bleehu/project-defuse/README.md

# project-defuse
A project to make an open-sourced hardware game in a similar vein to
