bleehu/project-defuse/hardware/checklist.md

* Don't design for production
    * Don't try to make a certain size or shape
* Test points
    * Voltages
    * Ground
    * Serial
* Diagnostic LEDs
    * Power
    * Ready LED
* Don't overcrowd
    * 0805
* Silkscreen
    * Label stuff
    * Pin 1 markings
    * Clearly label headers and test points
    * Orientation markings
    * Board name and rev
    * Label ICs
* Isolation jumpers
    * Cuttable jumpers between power sections
* Break out unused GPIO
* Check UART directions
* Double-check footprints
* Check parts availability
