bleehu/project-defuse/hardware/seg25_puzzle/Pinout.md

## Rev 1.0

| Pin # | GPIO # | Function |
| ----- | --- | --- |
| 1 | GP0 | Spare 5V-level-shifted output at TP18
| 2 | GP1 | TPIC6C595 OE - Output enable (active low)
| 4 | GP2 | TPIC6C595 SRCK - Shift register clock
| 5 | GP3 | TPIC6C595 SER_IN - Serial data MOSI
| 6 | GP4 | TPIC6C595 CLR - Clear (active low)
| 7 | GP5 | TPIC6C595 RCK - Register clock
| 9 | GP6 | Unused (why?)
| 10 | GP7 | 74HCT595 RCLK - Register clock
| 11 | GP8 | 74HCT595 SRCLR - Shift register clear (active low)
| 12 | GP9 | 74HCT595 OE - Output enable (active low)
| 14 | GP10 | 74HCT595 SRCLK - Shift register clock
| 15 | GP11 | 74HCT595 SER - Serial data MOSI
| 16 | GP12 | 74HCS165 Q_H - Serial output
| 17 | GP13 | 74HCS165 SH/LD - Shift when high, load when low
| 19 | GP14 | 74HCS165 CLK - Serial clock (rising edge)
| 20 | GP15 | 74HCS165 CLK INH - Clock inhibig (active low)
| 21 | GP16 | Spare - TP1
| 22 | GP17 | Spare - TP2
| 24 | GP18 | Spare - TP3
| 25 | GP19 | Spare - TP4
| 26 | GP20 | Spare - TP5
| 27 | GP21 | Spare - TP6
| 29 | GP22 | Spare - TP7
| 31 | GP26 | Spare - TP9
| 32 | GP27 | Spare - TP10
| 34 | GP28 | Spare - TP11

## Pinout Diagram

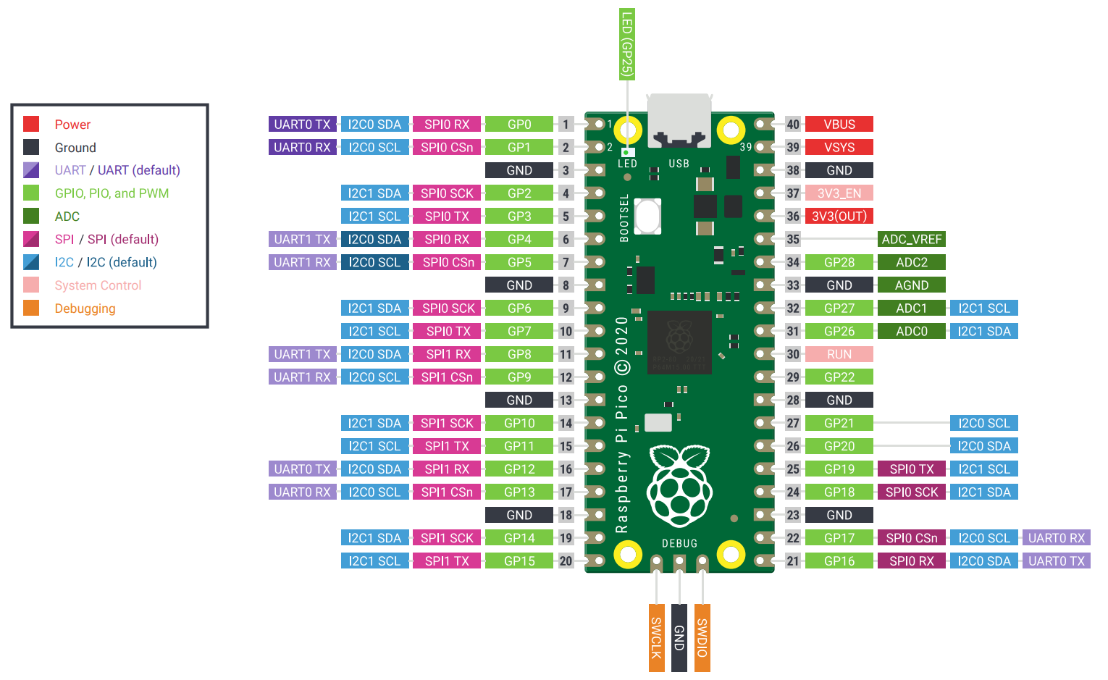
[picture p1: hardware/Pico_pinout.png]
Raspberry Pi Pico pinout diagram
