bleehu/project-defuse/hardware/seg25_puzzle/bom.md

| Qty | Part name | Link |
| --- | --- | ---- |
| 3 | TPIC6C595 | https://www.mouser.com/ProductDetail/595-TPIC6C595DG4
| 1 | 74HCT595  | https://www.mouser.com/ProductDetail/621-74HCT595S16-13
| 2 | 8x DIP switch | https://www.mouser.com/ProductDetail/774-2068
| 2 | 8x resistor array 100k | https://www.mouser.com/ProductDetail/652-4609X-1LF-100K
| 1 | 74HCT367 | https://www.mouser.com/ProductDetail/771-74HCT367D-T
| 1 | Screw terminal 2-pin | https://www.mouser.com/ProductDetail/490-TB003-500-P02BE
| 1 | Raspberry Pi Pico | https://www.mouser.com/ProductDetail/713-102110545
| 7 | BC808 | https://www.mouser.com/ProductDetail/637-BC808-40
| 2 | 74HCS165 | https://www.mouser.com/ProductDetail/595-SN74HCS165DR
| 7 | 100nF 0805 | From stock
| 3 | LED 3mm | From stock
| 2 | Header 3-pin | From stock
| 1 | DYSR00P401101 | https://www.radio741.com/40495-6-digit-16-25-segment-display-common-anode-arduino-compatible-dysr00p401101-micronova.html
|  26 | 1k 0805 | From stock
| 7 | 10k 0805 | From stock
