bleehu/project-defuse/hardware/seg25_puzzle/seg25_puzzle.kicad_pcb

## KiCad design hardware/seg25_puzzle/seg25_puzzle.kicad_pcb (2024-02-07)

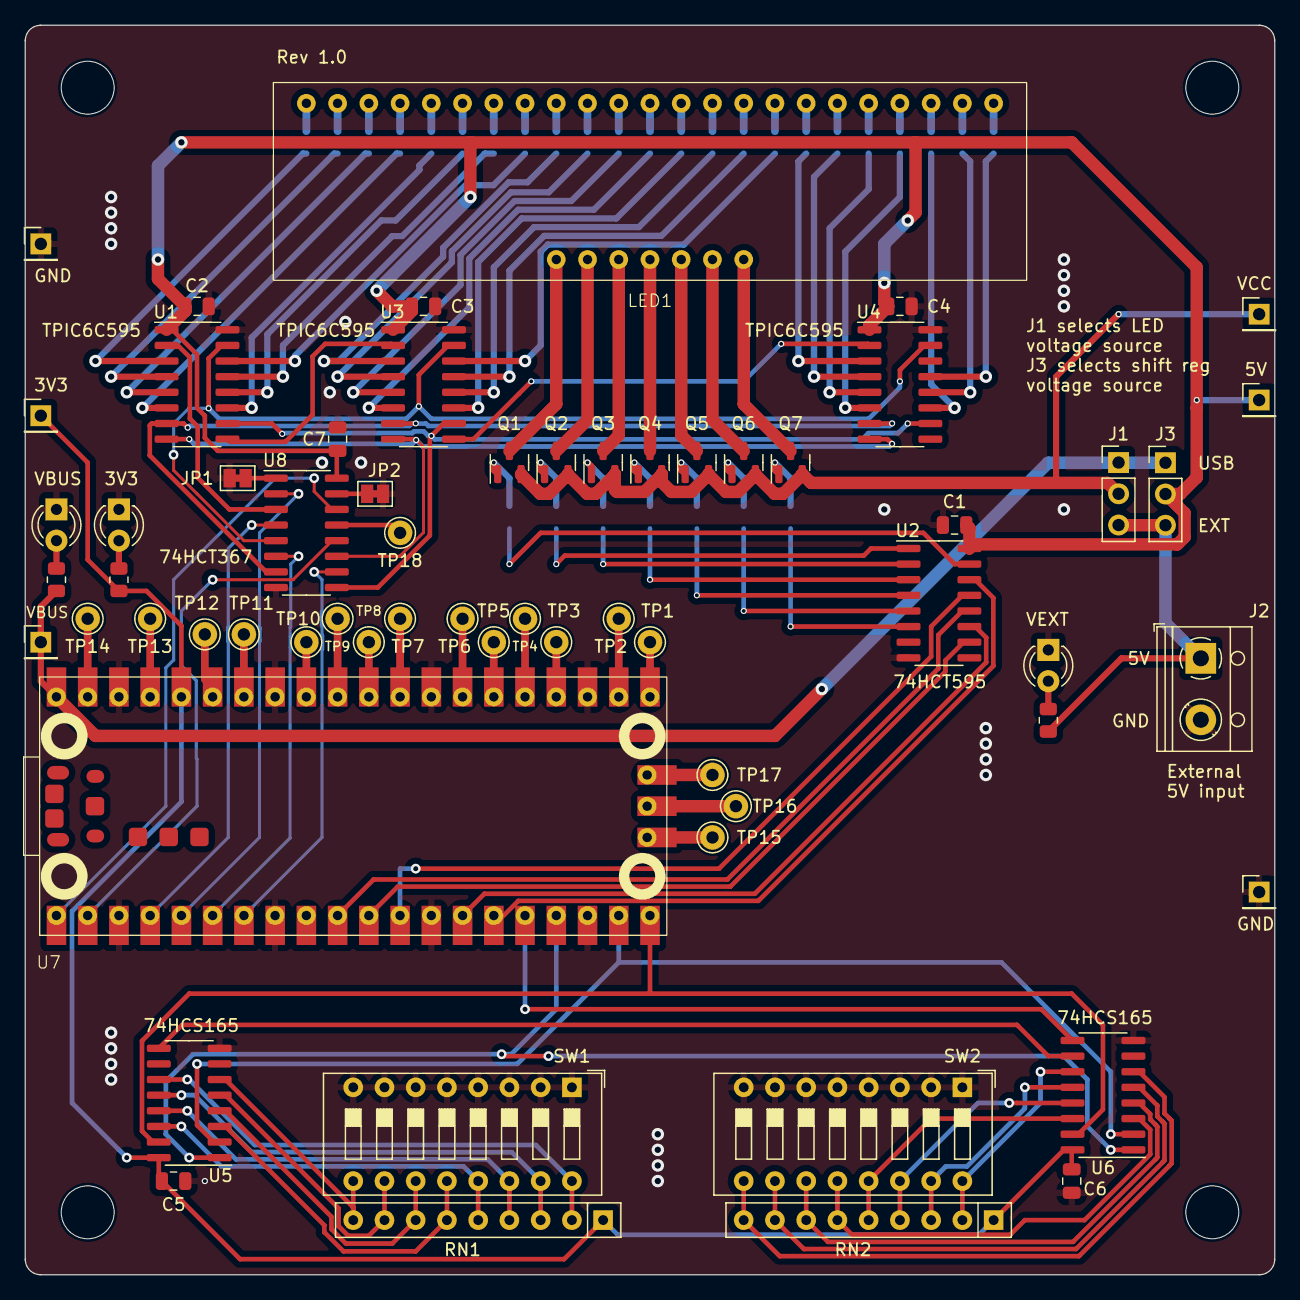
[picture p2: board seg25_puzzle.kicad_pcb from above]

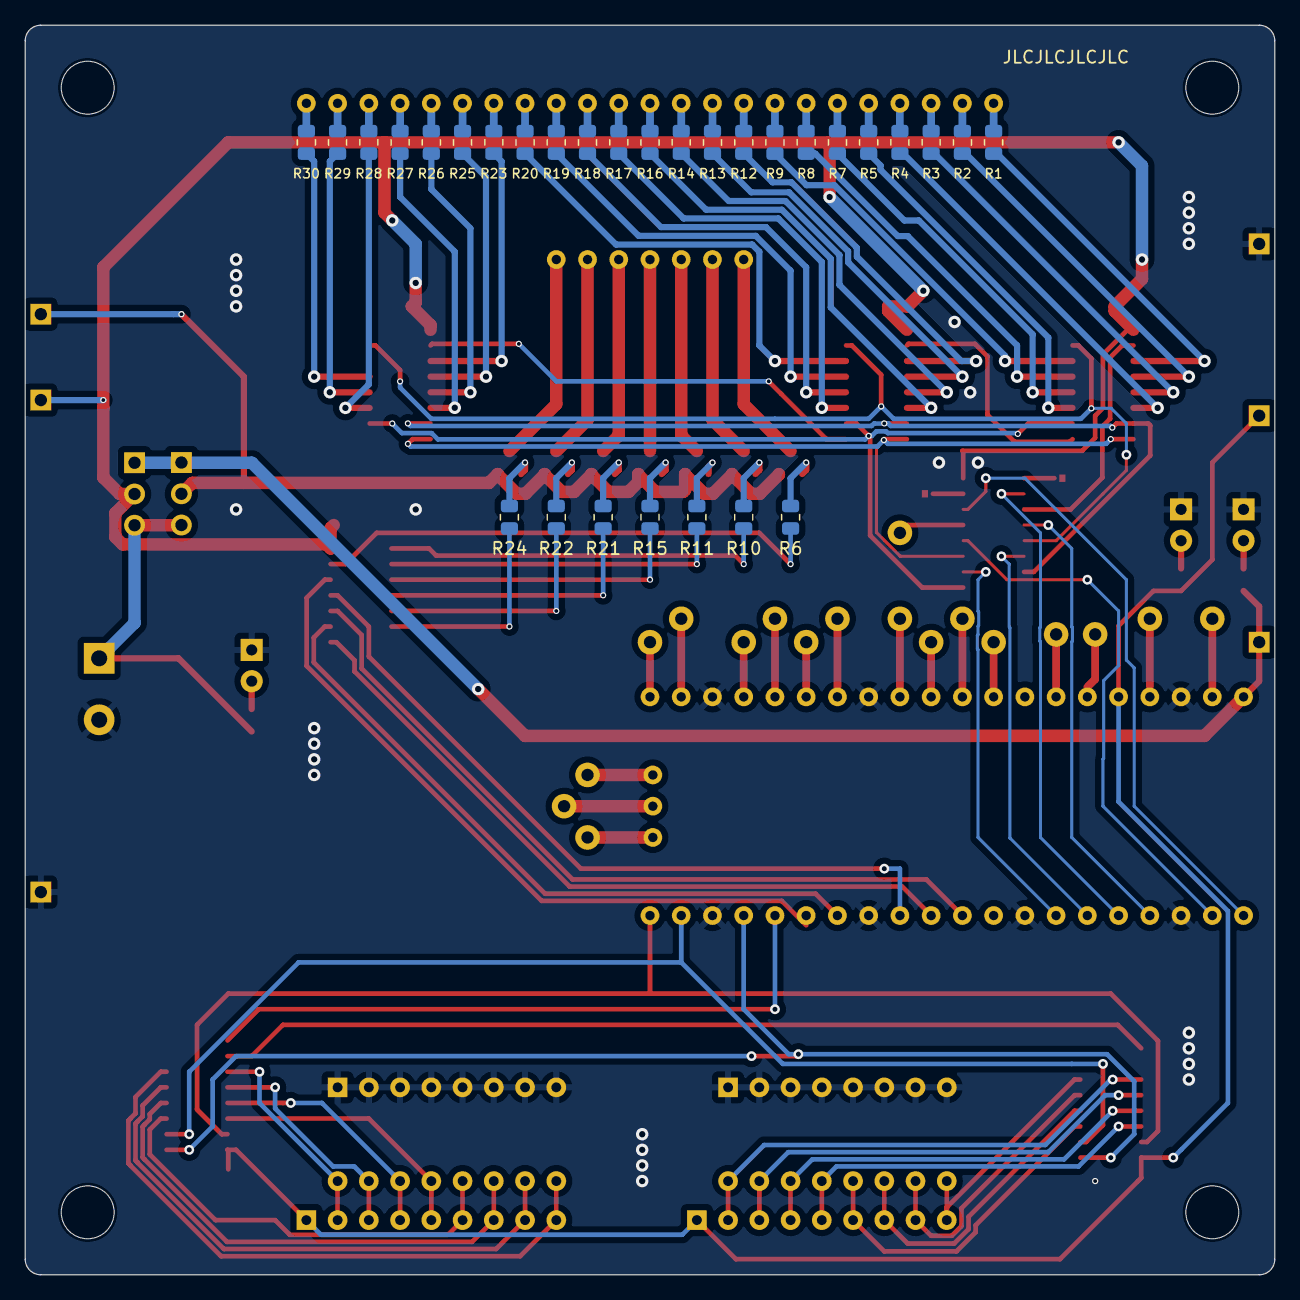
[picture p3: board seg25_puzzle.kicad_pcb from below]

Board: 2 copper layers, 101.6 x 101.6 mm, 96 parts (30 on the bottom side), 135 nets.

Parts:
C1, C2, C3, C4, C5, C6, C7: 100n; C_0805_2012Metric
D1, D2, D5: LED; LED_D3.0mm
H1, H2, H3, H4: MountingHole; MountingHole_4.3mm_M4
J1, J3: Conn_01x03_Pin; PinHeader_1x03_P2.54mm_Vertical
J2: Screw_Terminal_01x02; TerminalBlock_RND_205-00012_1x02_P5.00mm_Horizontal
JP1, JP2: Jump; SolderJumper-2_P1.3mm_Bridged_Pad1.0x1.5mm
LED1: DYSR00P401101
Q1, Q2, Q3, Q4, Q5, Q6, Q7: BC808; SOT-23
R1, R2, R3, R4, R5, R7, R8, R9, R12, R13, R14, R16, R17, R18, R19, R20, R23, R25, R26, R27, R28, R29, R30, R31, R32, R35: 1k; R_0805_2012Metric
R6, R10, R11, R15, R21, R22, R24: 10k; R_0805_2012Metric
RN1, RN2: 100k; R_Array_SIP9
SW1, SW2: SW_DIP_x08; SW_DIP_SPSTx08_Slide_9.78x22.5mm_W7.62mm_P2.54mm
TP1, TP2, TP3, TP4, TP5, TP6, TP7, TP8, TP9, TP10, TP11, TP12, TP13, TP14, TP15, TP16, TP17, TP18: TestPoint; Pin_D1.0mm_L10.0mm
TP19, TP20, TP21, TP22, TP23, TP24: TestPoint; PinHeader_1x01_P2.54mm_Vertical
U1, U3, U4: TPIC6C595; SOIC-16_3.9x9.9mm_P1.27mm
U2: 74HCT595; SOIC-16_3.9x9.9mm_P1.27mm
U5, U6: 74HCS165; SOIC-16_3.9x9.9mm_P1.27mm
U7: PiPico; PiPico_thru_and_surface
U8: 74HCT367; SOIC-16_3.9x9.9mm_P1.27mm

Connections:
165_CP: U5.2 (CP), U6.2 (CP), U7.19 (GP14)
165_MISO: U6.9 (Q7), U7.16 (GP12)
595_RCLK: U2.12 (RCLK), U7.10 (GP7)
595_SER: U2.14 (SER), U7.15 (GP11)
595_SRCLK: U2.11 (SRCLK), U7.14 (GP10)
+3V3: C5.1, C6.1, R32.2, RN1.1 (common), RN2.1 (common), TP22.1, U5.16 (VCC), U6.16 (VCC), U7.36 (3V3_OUT)
+5V: C1.1, C2.1, C3.1, C4.1, C7.1, J3.2, TP23.1, U1.1 (VCC), U2.16 (VCC), U3.1 (VCC), U4.1 (VCC), U8.16 (VCC)
/uC/SPARE_LEVEL_SHIFT: U7.1 (GP0), U8.14 (I6)
/uC/TPIC_CLR_3V3: U7.6 (GP4), U8.6 (I3)
/uC/TPIC_OE_3V3: U7.2 (GP1), U8.12 (I5)
/uC/TPIC_RCK_3V3: U7.7 (GP5), U8.10 (I4)
/uC/TPIC_SER_IN_3V3: U7.5 (GP3), U8.2 (I1)
/uC/TPIC_SRCK_3V3: U7.4 (GP2), U8.4 (I2)
GND: C1.2, C2.2, C3.2, C4.2, C5.2, C6.2, C7.2, D1.1 (K), D2.1 (K), D5.1 (K), J2.2, JP1.1 (A), JP2.1 (A), SW1.1, SW1.2, SW1.3, SW1.4, SW1.5, SW1.6, SW1.7, SW1.8, SW2.1, SW2.2, SW2.3, SW2.4, SW2.5, SW2.6, SW2.7, SW2.8, TP19.1, TP20.1, U1.16 (GND), U2.8 (GND), U3.16 (GND), U4.16 (GND), U5.8 (GND), U6.8 (GND), U7.3 (GND), U7.8 (GND), U7.13 (GND), U7.18 (GND), U7.23 (GND), U7.28 (GND), U7.33 (GND), U7.38 (GND), U8.8 (GND)
unnamed: D1.2 (A), R31.1
unnamed: D2.2 (A), R32.1
unnamed: D5.2 (A), R35.1
unnamed: J1.3, J2.1, J3.3, R35.2
unnamed: JP1.2 (B), U8.1 (OEa)
unnamed: JP2.2 (B), U8.15 (OEb)
unnamed: LED1.9 (COM1), Q1.3 (C)
unnamed: LED1.10 (COM2), Q2.3 (C)
unnamed: LED1.11 (COM3), Q3.3 (C)
unnamed: LED1.12 (COM4), Q4.3 (C)
unnamed: LED1.13 (COM5), Q5.3 (C)
unnamed: LED1.14 (COM6), Q6.3 (C)
unnamed: LED1.15 (COM7), Q7.3 (C)
unnamed: LED1.46 (a), R1.1
unnamed: LED1.45 (b), R2.1
unnamed: LED1.44 (c), R3.1
unnamed: LED1.43 (d), R4.1
unnamed: LED1.42 (e), R5.1
unnamed: LED1.41 (f), R7.1
unnamed: LED1.40 (g), R8.1
unnamed: LED1.39 (h), R9.1
unnamed: LED1.38 (i), R12.1
unnamed: LED1.37 (j), R13.1
unnamed: LED1.36 (k), R14.1
unnamed: LED1.35 (l), R16.1
unnamed: LED1.34 (m), R17.1
unnamed: LED1.33 (n), R18.1
unnamed: LED1.32 (o), R19.1
unnamed: LED1.31 (p), R20.1
unnamed: LED1.30 (r), R23.1
unnamed: LED1.29 (s), R25.1
unnamed: LED1.28 (t), R26.1
unnamed: LED1.27 (u), R27.1
unnamed: LED1.26 (v), R28.1
unnamed: LED1.25 (w), R29.1
unnamed: LED1.24 (x), R30.1
unnamed: Q1.1 (B), R6.2
unnamed: Q2.1 (B), R10.2
unnamed: Q3.1 (B), R11.2
unnamed: Q4.1 (B), R15.2
unnamed: Q5.1 (B), R21.2
unnamed: Q6.1 (B), R22.2
unnamed: Q7.1 (B), R24.2
unnamed: RN1.2 (R1), SW1.16, U5.11 (D0)
unnamed: RN1.3 (R2), SW1.15, U5.12 (D1)
unnamed: RN1.4 (R3), SW1.14, U5.13 (D2)
unnamed: RN1.5 (R4), SW1.13, U5.14 (D3)
unnamed: RN1.6 (R5), SW1.12, U5.3 (D4)
unnamed: RN1.7 (R6), SW1.11, U5.4 (D5)
unnamed: RN1.8 (R7), SW1.10, U5.5 (D6)
unnamed: RN1.9 (R8), SW1.9, U5.6 (D7)
unnamed: RN2.2 (R1), SW2.16, U6.11 (D0)
unnamed: RN2.3 (R2), SW2.15, U6.12 (D1)
unnamed: RN2.4 (R3), SW2.14, U6.13 (D2)
unnamed: RN2.5 (R4), SW2.13, U6.14 (D3)
unnamed: RN2.6 (R5), SW2.12, U6.3 (D4)
unnamed: RN2.7 (R6), SW2.11, U6.4 (D5)
unnamed: RN2.8 (R7), SW2.10, U6.5 (D6)
unnamed: RN2.9 (R8), SW2.9, U6.6 (D7)
unnamed: TP16.1, U7.D2 (GND)
unnamed: R1.2, U1.3 (DRAIN0)
unnamed: R2.2, U1.4 (DRAIN1)
unnamed: R3.2, U1.5 (DRAIN2)
unnamed: R4.2, U1.6 (DRAIN3)
unnamed: R5.2, U1.11 (DRAIN4)
unnamed: R7.2, U1.12 (DRAIN5)
unnamed: R8.2, U1.13 (DRAIN6)
unnamed: R9.2, U1.14 (DRAIN7)
unnamed: U1.9 (SER_OUT), U3.2 (SER_IN)
unnamed: R6.1, U2.15 (QA)
unnamed: R10.1, U2.1 (QB)
unnamed: R11.1, U2.2 (QC)
unnamed: R15.1, U2.3 (QD)
unnamed: R21.1, U2.4 (QE)
unnamed: R22.1, U2.5 (QF)
unnamed: R24.1, U2.6 (QG)
unnamed: R12.2, U3.3 (DRAIN0)
unnamed: R13.2, U3.4 (DRAIN1)
unnamed: R14.2, U3.5 (DRAIN2)
unnamed: R16.2, U3.6 (DRAIN3)
unnamed: R17.2, U3.11 (DRAIN4)
unnamed: R18.2, U3.12 (DRAIN5)
unnamed: R19.2, U3.13 (DRAIN6)
unnamed: R20.2, U3.14 (DRAIN7)
unnamed: U3.9 (SER_OUT), U4.2 (SER_IN)
unnamed: R23.2, U4.3 (DRAIN0)
unnamed: R25.2, U4.4 (DRAIN1)
unnamed: R26.2, U4.5 (DRAIN2)
unnamed: R27.2, U4.6 (DRAIN3)
unnamed: R28.2, U4.11 (DRAIN4)
unnamed: R29.2, U4.12 (DRAIN5)
unnamed: R30.2, U4.13 (DRAIN6)
unnamed: U5.9 (Q7), U6.10 (DS)
unnamed: TP13.1, U7.37 (3V3_EN)
unnamed: TP12.1, U7.35 (ADC_VREF)
unnamed: TP1.1, U7.21 (GP16)
unnamed: TP2.1, U7.22 (GP17)
unnamed: TP3.1, U7.24 (GP18)
unnamed: TP4.1, U7.25 (GP19)
unnamed: TP5.1, U7.26 (GP20)
unnamed: TP6.1, U7.27 (GP21)
unnamed: TP7.1, U7.29 (GP22)
unnamed: TP9.1, U7.31 (GP26)
unnamed: TP10.1, U7.32 (GP27)
unnamed: TP11.1, U7.34 (GP28)
unnamed: TP8.1, U7.30 (RUN)
unnamed: TP15.1, U7.D1 (SWCLK)
unnamed: TP17.1, U7.D3 (SWDIO)
unnamed: TP14.1, U7.39 (VSYS)
unnamed: TP18.1, U8.13 (O6b)
TPIC_OE: U1.8 (~G), U3.8 (~G), U4.8 (~G), U8.11 (O5b)
TPIC_RCK: U1.10 (RCLK), U3.10 (RCLK), U4.10 (RCLK), U8.9 (O4a)
TPIC_SER_IN: U1.2 (SER_IN), U8.3 (O1a)
TPIC_SRCK: U1.15 (SRCK), U3.15 (SRCK), U4.15 (SRCK), U8.5 (O2a)
VBUS: J1.1, J3.1, R31.2, TP21.1, U7.40 (VBUS)
VCC: J1.2, Q1.2 (E), Q2.2 (E), Q3.2 (E), Q4.2 (E), Q5.2 (E), Q6.2 (E), Q7.2 (E), TP24.1
~165_CE: U5.15 (~CE), U6.15 (~CE), U7.20 (GP15)
~165_PL: U5.1 (~PL), U6.1 (~PL), U7.17 (GP13)
~595_OE: U2.13 (~OE), U7.12 (GP9)
~595_SRCLR: U2.10 (~SRCLR), U7.11 (GP8)
~TPIC_CLR: U1.7 (~CLR), U3.7 (~CLR), U4.7 (~CLR), U8.7 (O3a)
