bleehu/project-defuse/firmware/seg25_puzzle/main.cpp

#include "pico/stdlib.h"

#include "display.h"
#include "switches.h"

uint16_t xorshift_state = 1;

uint16_t xorshift()
{
    xorshift_state ^= xorshift_state << 7;
    xorshift_state ^= xorshift_state >> 9;
    xorshift_state ^= xorshift_state << 8;
    return xorshift_state;
}

void update_display_from_switches(uint16_t switches)
{
    switch (switches)
    {
    case 0:
    {
        update_display("HELLO!");
        break;
    }
    case 1:
    {
        update_display(u"ABCDEF");
        break;
    }
    case 2:
    {
        update_display(u"GHIJKL");
        break;
    }
    case 3:
    {
        update_display(u"MNOPQR");
        break;
    }
    case 4:
    {
        update_display(u"STUVWX");
        break;
    }
    case 5:
    {
        update_display(u"YZ0123");
        break;
    }
    case 6:
    {
        update_display(u"456789");
        break;
    }
    case 7:
    {
        update_display(u"!@#$%^");
        break;
    }
    case 8:
    {
        update_display(u"&*()_+");
        break;
    }
    case 9:
    {
        update_display(u"`~-=");
        break;
    }
    case 10:
    {
        update_display(u"<>[]{}");
        break;
    }
    case 11:
    {
        update_display(u"/|\\?");
        break;
    }
    case 12:
    {
        update_display(u"βΓΣδζλ");
        break;
    }
    case 13:
    {
        update_display(u"μΞΠπσΨ");
        break;
    }
    case 14:
    {
        update_display(u"א");
        break;
    }
    case 0x0100:
    {
        // A demo/test of the various additional marks
        Display d = string_to_display("ACUEOI");
        add_marks_to_digit(d, 0, ACUTE);
        add_marks_to_digit(d, 1, BOTTOM_RIGHT);
        add_marks_to_digit(d, 2, DOT_TOP_LEFT | DOT_TOP_RIGHT);
        add_marks_to_digit(d, 3, ACUTE | GRAVE | DECIMAL_POINT);
        add_marks_to_digit(d, 4, TOP_OF_COLON | DOT_TOP_LEFT | DOT_TOP_RIGHT);
        add_marks_to_digit(d, 5, DOT_TOP_LEFT | DOT_TOP_RIGHT | BOTTOM_LEFT | BOTTOM_RIGHT);

        update_display(d);
        break;
    }

    case 0xFFFF:
    {
        Display d;

        // Turn all segments on
        for (uint8_t digit = 0; digit < 7; ++digit)
        {
            d.digits[digit] = 0xFFFFFF;
        }
        update_display(d);
        break;
    }
    default:
    {
        Display d;

        // Generate some pseudorandom data seeded from the switch state
        xorshift_state = switches;
        for (uint8_t digit = 0; digit < 7; ++digit)
        {
            d.digits[digit] = xorshift() | (xorshift() << 16);
        }

        update_display(d);

        break;
    }
    }

}


int main()
{
    init_switches();

    init_display();

    while (true)
    {
        auto switches = read_switches();

        update_display_from_switches(switches);

        sleep_ms(10);
    }
}
