bleehu/project-defuse/(commit log)

2024-02-07 Initial commit with 25-segment display / DIP switch puzzle board 1.0
    [dip_switches.kicad_sch, led_display.kicad_sch, seg25_puzzle.kicad_pcb, seg25_puzzle.kicad_sch, uc.kicad_sch]
2024-02-07 Add BOM and Interactive BOM
2024-02-17 Add a blink example project for the prototype board
2024-02-17 Add switch support
    Generate random characters except when all switches are off, then it displays "Hello!"
2024-02-18 Move switch reading code to a separate file
